lzzZ26/Cortexm0ds/shipinjiaoben/讲解视频脚本.md

# 讲解视频脚本（8 分钟 · 最终版）

> **拆分说明（2026-10-19 更新）**：最终采用"两人各 4 分钟"合成方案。  
> **RTL 部分（0:00–4:00）**：见同目录 **[讲解视频脚本_RTL部分_4分钟.md](讲解视频脚本_RTL部分_4分钟.md)**（已按最新口径重写）。  
> **FPGA 部分（4:00–8:00）**：由另一位同学负责，本文件仅保留总体分镜参考。  
> 本文件其余内容为合并版参考稿，实际录制以 4 分钟 RTL 稿 + FPGA 同学稿件拼接为准。

> **用途**：初赛/决赛"汇报 PPT 及讲解视频"录制。  
> **依据**：赛题要求（PPT≤15 页、视频 mp4、8 分钟）+ 本项目 [README.md](../README.md) 的最终状态。  
> **口径**：FPGA 板级已按 `CORE_TYPE=2`（通用并行核）完成综合与运行；Q18 任意非对称系数在板级与 RTL 三层仿真均闭环。  
> **注意**：全片不得出现学校、队伍、指导老师等识别信息；只讲设计与数据。

---

## 一、录制前置（录前检查）

| 项 | 要求 |
|---|---|
| 视频 | mp4，1920×1080，≤8:00（建议 7:50 收尾），普通话，无背景噪声 |
| PPT | ≤15 页；本脚本按 14 页编排（P1–P14），可合并但不超 15 页 |
| 画面素材 | 架构图、代码片段、仿真图、GTKWave 波形、串口输出、PDS 报告截图 |
| 关键图 | `docs/report/figures/q18_impulse_compare.svg`（Q18 核心证据） |
| 串口素材 | 固件四标记：横幅 / `** ECHO PASS **` / `** DMA PASS **` / `** FIR DONE **` |
| 口径核对 | 吞吐 1.0 sample/cycle；DMA 带宽 14.44 MB/s；系统延迟 3.04 μs；50MHz；APM 82/84（CORE_TYPE=2） |

> 建议语速：约 300 字/分钟。下文每段"讲稿"按该语速配时，可直接照读。

---

## 二、分镜脚本（时间 · PPT · 画面 · 讲稿）

### 0:00–0:30　P1 封面：一句话定位（约 150 字）

**画面**：PPT 封面；右下角小字"RTL 三层验证全绿 · FPGA 板级完成"。

**讲稿**：
> "本作品是'带高阶 FIR 数字滤波器的 SoC 处理器设计'。一句话概括：以 Cortex-M0 为控制核，自研 AXI 多主互连、6 通道 DMA 和**支持任意非对称系数的 81 阶 FIR**，吞吐 1 个样本每拍。RTL 三层验证全绿，FPGA 板级已按通用核综合运行。"

---

### 0:30–1:20　P2 痛点与工程问题（约 250 字）

**画面**：左侧"软件 FIR 太慢"示意图；右侧官方参考工程三处缺口（无多主仲裁、无 DMA、mux/SRAM 并发缺陷）。

**讲稿**：
> "先看问题。边缘设备要同时做系统控制和信号处理。让 CPU 跑 81 阶 FIR，每个样本 82 次乘加，实时性很快见底；纯硬件又难以应对灵活控制。异构 SoC 是标准答案。
>
> 但我们拿到官方参考工程后发现三个工程问题：第一，它只有单主设备，没有多主总线仲裁，源码注释明确写着'没有 DMA 控制器，因此不需要主设备复用器'；第二，没有 DMA，CPU 搬运数据会吃掉大量算力；第三，官方从机复用器和 SRAM 模型在多主并发下有隐藏缺陷——路由会被其他主机的请求刷新，读在途时写会被静默丢弃。这三块，就是我们要补的拼图。"

---

### 1:20–2:10　P3 总体架构（约 250 字）

**画面**：README 架构图（CPU→AHB2AXI→自研仲裁器→自研从机 mux→SRAM/FIR/DMA/APB）。自研模块用蓝色，官方复用用灰色。

**讲稿**：
> "总体架构：Cortex-M0 通过官方 AHB 转 AXI 桥进入 AXI 世界；自研的双主轮询仲裁器把 CPU 和 DMA 两个主设备接到共享总线上；自研的从机复用器按地址选通，把事务分发给 SRAM、FIR、DMA 配置口和官方 APB 子系统。低速外设侧复用官方 AXI 转 APB 桥。
>
> 关键点是：计分模块——仲裁器、从机 mux、地址译码、SRAM 模型、FIR、DMA、ROM——全部自研；官方只读复用指定 CPU 和配套桥。数据流是：SRAM 输入经 DMA 送 FIR，滤波结果再由 DMA 搬回 SRAM，CPU 只负责配系数、下发任务和读结果。"

---

### 2:10–3:10　P4–P5 FIR 三核与 Q18（约 300 字）

**画面**：P4 三核对比表（para 82 乘法器 / sym 41 / serial 1）；P5 Q18 说明：官方答疑原话"支持任意非对称系数"。

**讲稿**：
> "FIR 是本设计的性能核心，也是合规关键。官方答疑明确要求'81 阶可配置系数 FIR，支持任意非对称系数，对称优化只能作为可选分支'。所以我们把**通用全并行核**作为基本架构：82 个独立系数寄存器乘 82 个乘法器，任意非对称系数直接可用，吞吐 1 个样本每拍。
>
> 系数对称时，提供可选的对称优化分支：预加对加 41 个乘法器，资源省一半；通过 CTRL 模式位切换，切换一定伴随全清，不会带脏历史样本。再往下还有单乘法器的串行核，作为资源下限保底。
>
> 一句话：**任意非对称系数是基本盘，对称优化是加分项**。"

---

### 3:10–4:00　P6 定点格式与精度（约 250 字）

**画面**：定点链路图：输入/系数 Q1.15 → 乘积 Q2.30 → 40bit 累加 Q10.30 → 输出 Q1.31；右侧黄金模型流程。

**讲稿**：
> "定点格式全链路统一：输入和系数是 16 位 Q1.15；乘积 Q2.30；82 项累加用 40 位 Q10.30，不会溢出；输出取累加值乘 2 的低 32 位，饱和到 Q1.31。
>
> 这里有两个实现细节：累加器必须声明为有符号，否则 Verilog 会把含乘法的整式按无符号求值；饱和判据必须查满高 10 位，因为 82 项求和可能超过正负 4，只看最高两位会漏判。
>
> 验证口径按官方答疑：**相对均方根误差小于 0.1%**。我们采用更强的逐样本点态上界：每个样本都满足误差不超过参考值的千分之一，数学上蕴含 RMSE 要求。"

---

### 4:00–4:50　P7 DMA：6 通道与链式（约 250 字）

**画面**：DMA 通道框图（读 burst→16 字 FIFO→写 burst）；右侧 7 类用例/6 通道并发/3 段链表示意。

**讲稿**：
> "DMA 有 6 个独立通道，每通道可配源地址、目的地址、传输长度，完成后可发中断。难点在字节精度：源和目的可以任意字节对齐，长度任意，总线又没有字节选通，所以我们用'头尾单拍字节 burst + 中间整字 burst'的三段式搬移，保证零差错。
>
> 链式传输是决赛创新点：每个通道完成后，自动从 NEXT 指针读取下一段描述符继续执行，多段串联不需要 CPU 干预。测试里 3 段链表自动串联、末段中断，全部通过。"

---

### 4:50–5:30　P8 工程难题：BURST 提速死锁（约 200 字）

**画面**：死锁环路示意（ch0 写停等 → 持有授权 → ch1 饿死 → 核无输入/输出 → 循环等待）。

**讲稿**：
> "讲一个真实的工程问题。我们曾把 DMA 的 burst 从单拍提到 8 拍想提速，系统级仿真直接死锁。机制是：输出通道的多拍读追上滤波核产出率，在 DOUT 空时挂起；输入通道的多拍写填满 DIN，而核因为输出满被冻结；停等期间通道一直持有总线授权，另一条通道就饿死了。
>
> 全单拍配置因为'输入受限的锁步节奏'恰好安全。我们把它固化为安全配置，并把根治方向——DMA 双主口——写进了分析文档。"

---

### 5:30–6:20　P9–P10 验证体系与结果（约 250 字）

**画面**：三层验证金字塔；17 个回归目标清单；Q18 冲激对比图（左对称/右非对称）。

**讲稿**：
> "验证按赛题要求分三层。第一层单元/模块：FIR 三个核、DMA、仲裁器、译码、ROM 各有独立 Testbench。第二层集成验证，不含 CPU：VIP 替代 CPU，用真实互连拓扑跑 SRAM 往返、82 系数配置、1024 样本滤波，并且同时验证对称和非对称两轮。第三层系统测试，含 CPU：固件跑 UART 回显、6 通道 DMA 自检、软硬协同滤波，TB 读回 SRAM 逐样本比对黄金模型。
>
> 全量回归 **17 个目标全部通过**，协议检查器零违规。
>
> 右边这张图是 Q18 的直接证据：横轴 82 个抽头。上面是对称系数，冲激响应左右镜像，首尾都是 `0x0004FFF6`；下面是非对称系数，右边首值 `0x16C1D27C`、末值 `0xA633B39A`，左右明显不同。这就是'任意非对称系数'的可视化证明。"

---

### 6:20–7:00　P11–P12 FPGA 验证（约 200 字）

**画面**：PDS 综合报告截图；板卡照片/串口输出；CORE_TYPE=2 配置；50MHz 时序摘要。

**讲稿**：
> "FPGA 侧在 MES50HP 开发板上按 `CORE_TYPE=2` 综合——也就是通用并行核，82 个乘法器支持任意非对称系数。PDS 完成综合、布局布线和 bit 流生成，50MHz 时序收敛；通用核占 82 个 APM，板上乘法器总占用 82/84。
>
> 板上实际运行通过：串口打印横幅、回显通过、DMA 自检通过、FIR 完成。板级时钟采用板载 50MHz 直连，不使用厂商 PLL 或 IP 原语，满足答疑要求。"

---

### 7:00–7:40　P13 同行比较与创新点（约 200 字）

**画面**：对比表：官方参考 vs 本设计（多主仲裁、6 通道 DMA、链式、任意非对称 FIR、并发缺陷修复）。

**讲稿**：
> "和官方参考架构相比，我们补上了多主仲裁和 6 通道 DMA；修复了官方从机 mux 的路由刷新问题和 SRAM 的读写互斥缺陷；FIR 从软件实现变成全硬件、1 样本每拍的加速器，并且把'任意非对称系数'做成默认路径，对称优化作为可选分支。
>
> 创新点集中在三处：一是 Q18 合规的三核架构；二是 DMA 链式传输；三是面向多主并发的仲裁与路由设计。"

---

### 7:40–8:00　P14 成果与应用（约 100 字）

**画面**：应用场景图（传感器滤波/电机控制/音频预处理）；结束页。

**讲稿**：
> "这套设计可以直接用于边缘传感器滤波、电机控制和音频预处理。FIR、DMA 和互连都是参数化的，换工艺、换板卡可以复用。以上是全部汇报，谢谢。"

---

## 三、逐段配时与字数核对

| 时间段 | 页面 | 讲稿字数（约） | 累计 |
|---|---|---:|---:|
| 0:00–0:30 | P1 | 150 | 0:30 |
| 0:30–1:20 | P2 | 250 | 1:20 |
| 1:20–2:10 | P3 | 250 | 2:10 |
| 2:10–3:10 | P4–P5 | 300 | 3:10 |
| 3:10–4:00 | P6 | 250 | 4:00 |
| 4:00–4:50 | P7 | 250 | 4:50 |
| 4:50–5:30 | P8 | 200 | 5:30 |
| 5:30–6:20 | P9–P10 | 250 | 6:20 |
| 6:20–7:00 | P11–P12 | 200 | 7:00 |
| 7:00–7:40 | P13 | 200 | 7:40 |
| 7:40–8:00 | P14 | 100 | 8:00 |

合计约 2400 字，按 300 字/分钟约 8 分钟；建议实际录制控制在 7:40–7:55。

---

## 四、录制素材清单（按出现顺序）

| 序号 | 素材 | 来源/生成命令 |
|---:|---|---|
| 1 | 架构图 | README §2.1；或 `docs/report/技术报告.md` 架构图 |
| 2 | 三核对比表 | README §2.5 |
| 3 | 定点链路图 | 技术报告 §1.2 |
| 4 | Q18 冲激对比图 | `docs/report/figures/q18_impulse_compare.svg` |
| 5 | GTKWave 波形（可选） | `sim_out/q18_impulse.vcd` / `q18_impulse_sym.vcd` |
| 6 | 串口四标记 | `tb_soc` 仿真输出或板上串口截图 |
| 7 | 17 目标回归 | `mingw32-make -f Makefile.fir regression` 输出 |
| 8 | PDS 综合/时序 | 板级 PDS 报告截图（APM 82/84、50MHz 收敛） |
| 9 | 板卡/bit 流 | 板级工程截图 |

> 录屏建议：Q18 对比图用浏览器全屏展示 3–5 秒；回归结果滚动到"全部 PASS"；串口输出停在四标记齐全的一屏。

---

## 五、录制注意事项（避免扣分）

1. **不出现识别信息**：学校、队伍名、指导老师、姓名、单位 logo 一律不出现在画面和口播中。
2. **数字口径一致**：吞吐 1.0 sample/cycle、DMA 带宽 14.44 MB/s、系统延迟 3.04 μs、50MHz；不要临场改数。
3. **Q18 表述准确**：任意非对称系数是默认路径；对称 41 乘加是**可选**分支，不要说成"只能对称"。
4. **FPGA 表述准确**：板级按 `CORE_TYPE=2`（通用并行核）综合；资源口径以 PDS 报告为准（APM 82/84）。
5. **误差口径**：说"相对均方根误差 <0.1%（逐样本 0.0977% 点态上界验证）"，不要只说"误差 0.1%"。
6. **视频长度**：严格 ≤8:00；建议录 7:40–7:55，留剪辑余量。

---

## 附录 A：5 分钟 FPGA 演示视频分镜（决赛可选）

| 时间 | 画面 | 操作/口播 |
|---|---|---|
| 0:00–0:30 | 开发板与上位机 | 上电、串口终端打开；介绍板卡与外设 |
| 0:30–1:00 | 串口横幅 | 复位后打印 `FIR-SoC Demo` |
| 1:00–1:40 | UART 回显 | 发送 64 字符，终端原样回显，出现 `** ECHO PASS **` |
| 1:40–2:40 | DMA 自检 | 6 通道搬运，出现 `** DMA PASS **` |
| 2:40–4:00 | FIR 软硬协同 | CPU 配系数、DMA 搬 1024 样本，出现 `** FIR DONE **` |
| 4:00–4:40 | Q18 演示（若现场可切换） | 说明 CORE_TYPE=2 通用核支持任意非对称系数；展示冲激响应/串口数据 |
| 4:40–5:00 | 收尾 | 板卡运行状态、LED/串口稳定，结束 |

> 演示视频只做"功能正确"展示，不在板上跑长循环误差校验；结果核对由仿真 TB 与离线数据完成（避免 M0 长循环取信异常）。

---

## 附录 B：与 README/PPT 的对应关系

| 本脚本段落 | README 章节 | PPT 页 |
|---|---|---|
| P2 痛点 | §1/§3 | P2 |
| P3 架构 | §2.1–2.4 | P3 |
| P4–P5 三核/Q18 | §2.5、§6 | P4–P5 |
| P6 定点/精度 | §4.4、技术报告 §1.2 | P6 |
| P7 DMA | §2.3、技术报告 §3.3 | P7 |
| P8 死锁 | 技术报告 §3.3 | P8 |
| P9–P10 验证 | §4.1–4.3 | P9–P10 |
| P11–P12 FPGA | §4.5 | P11–P12 |
| P13 比较/创新 | §5 决赛表 | P13 |
| P14 应用 | §10 | P14 |
