lzzZ26/Cortexm0ds/docs/走读笔记-官方参考工程.md

# 走读笔记：官方参考工程（AI初稿，待团队按源码核对）

> **状态**：AI于2026-10-02根据对 `D:\ICT\Cortexm0ds` 源码的阅读起草。
> **使用方式**：团队三人按附录D分工逐条对照源码核实（✅核实无误 / ❌修正并注明），
> 核实完成后删除本提示框，作为技术报告「体系结构设计」章节底稿。
> 来源：本仓库git历史（最新提交 569f446 Revert "版本20260825"，2026-10-01）

## 1. 系统顶层接线（mcu_system/cmsdk_mcu_system/cmsdk_mcu_system.v）

- CPU集成层 `cortexm0integration` 对外是 **AXI-Lite主口**，信号命名：`AW_VALID/AW_READY/AW_SIZE[2:0]/AW_BURST[1:0]/AW_LEN[7:0]/AW_ADDR[31:0]/W_VALID/W_READY/W_LAST/W_DATA[31:0]/B_VALID/B_READY/B_RESP[1:0]/AR_*/R_*`（`cm0_*`前缀）
- 系统共享总线 `sys_*` = 单主直连：源码注释 **"No DMA controller - no need to have master multiplexer"** → 我们补多主仲裁的位置
- 从机风格：**SEL选择线**（`AW_SELx/AR_SELx` 由译码产生，选中才响应）；**W通道不进mux**——`W_VALID/W_DATA/W_LAST`广播给全部从机，从机按自己AW锁存的选中自行消费
- 中断分配：`intisr_cm0[5:0]=apbsubsys_interrupt[5:0]`，`[6]=apb[6]|gpio0_combintr`，`[7]=apb[7]|gpio1_combintr`，`[14:8]=apb[14:8]`，`[15]=apb[15]`，`[31:16]=apb[31:16]|gpio0_intr`，`NMI=watchdog_interrupt`

## 2. CPU集成层端口（core/cortexm0_integration/cortexm0integration.v）

参数：`BKPT/DBG/NUMIRQ(32)/SMUL(0)/SYST(1)/WIC(0)/WICLINES(34)/WPT`。除AXI主口外要点：`FCLK/SCLK/ACLK/DCLK/PORESETn/DBGRESETn/ARESETn/SWCLKTCK/nTRST`、调试（`SWDITMS/TDI/SWDO/SWDOEN/TDO/nTDOEN/DBGRESTART/DBGRESTARTED/EDBGRQ/HALTED`）、`NMI/IRQ[31:0]/TXEV/RXEV/LOCKUP/SYSRESETREQ/IRQLATENCY/ECOREVNUM`、功耗管理（`GATEHCLK/SLEEPING/SLEEPDEEP/WAKEUP/WICSENSE/SLEEPHOLDREQn/SLEEPHOLDACKn/WICENREQ/WICENACK/CDBGPWRUPREQ/CDBGPWRUPACK`）、`SE/RSTBYPASS`。内部实例化 `ahb2axi4_if`（即AHB→AXI4桥，FR-6对应项）。
**核对**：本AI未逐行核对cortexm0integration.v的端口全表，仅从cmsdk_mcu_system.v的实例化反推——**必须对照源码确认**。

## 3. 官方从机复用器（cmsdk_axi_slave_mux.v）

- 10个从机口（PORT0-9），`PORTx_ENABLE`参数开关，`DW=32`
- 主侧信号：`AW_VALID/AW_READY/W_READY/B_VALID/B_RESP/AR_VALID/AR_READY/R_VALID/R_LAST/R_DATA/R_RESP`（**无W通道**，见第1条）
- 从机侧每口：`AW_SELx/AW_READYx/W_READYx/B_VALIDx/B_RESPx/AR_SELx/AR_READYx/R_VALIDx/R_LASTx/R_DATAx/R_RESPx`

## 4. 官方地址映射（cmsdk_axi_addr_decode.v）

| 区域 | 地址 | 说明 |
|---|---|---|
| Flash | 0x0000_0000-0x0000_FFFF | 只读，固件XIP；`filename`参数→$readmemh |
| SRAM | 0x2000_0000-0x2000_FFFF | 64K |
| APB子系统 | 0x4000_0000-0x4000_FFFF | UART0-2/Timer0-1/DualTimer/WDT/测试从机 |
| GPIO0/1 | 0x4001_0000 / 0x4001_1000 | AXI GPIO |
| SYSCTRL | 0x4001_F000 | REMAP等 |
| ROM表 | 0xF000_0000 | |
| 默认从机 | 其余 | DECERR |

## 5. AXI→APB桥（cmsdk_axi_to_apb/axi2apb_axi.v）

FR-6对应项。**核对项**：其对burst/size的处理方式（逐拍转APB？）、PCLKEN分频用法。

## 6. APB子系统（cmsdk_axi2apb_subsystem.v）

**核对项（集成必查）**：`apbsubsys_interrupt`各位中断源——本AI推断 `[0]=UART0 TX、[1]=UART0 RX、[2]=UART1 TX、[3]=UART1 RX、[4]=UART2 TX、[5]=UART2 RX、[6]=TIMER0、[7]=TIMER1、[8:11]=DUALTIMER、[14]=WATCHDOG`，**未经源码确认**。

## 7. 存储模型（cmsdk_axi_flash.v / cmsdk_axi_sram.v）

- Flash：`#(.filename(...), .AW(16), .WS_N/WS_S(来自cmsdk_axi_memory_defs.v的宏))`，只读（写回DECERR），AR侧1拍延迟风格
- SRAM：同样参数化；字节/半字写靠 **AWSIZE+低位地址通道**（CMSDK总线无WSTRB）
- FPGA注意：flash模型是否可综合未确认 → 计划用axi_rom替代（任务15）

## 8. UART（cmsdk_apb_uart.v）

- 波特率分频寄存器（DLL/DLM或等价）、状态位（TXFULL/RXFULL）、TX/RX中断
- 固件驱动用CMSDK_driver（uart_stdout.c）；**核对**：UartStdOutInit默认的UART选择（TB注释为UART2/P1[5]）与波特率（9600）

## 9. 固件框架（software/）

- `retarget.c + uart_stdout.c`：printf→UART stdout；`hello.c`调用`UartStdOutInit()`后printf
- `startup_CMSDK_CM0.s`(GCC版)：向量表；**核对**：IRQ16对应的弱符号名（预期`IRQ16_Handler`）
- `cmsdk_cm0.ld`：FLASH 0x0 64K（rx），RAM 0x20000000 63K（rwx）——注释已为DMA结构预留空间
- 编译流程（hello/makefile）：`arm-none-eabi-gcc -mcpu=cortex-m0 -mthumb ... -T cmsdk_cm0.ld -o x.o` → `objcopy -O verilog x.hex`

## 10. 仿真TB（tb/）

- `tb_cmsdk_mcu`：实例化cmsdk_mcu，`filename="image.hex"`，`cmsdk_clkreset`给时钟复位，`cmsdk_uart_capture`捕获UART输出并在结尾`$stop`
- **坑**：TB无条件`$dumpfile("wave2.vcd")+$dumpvars` → 生成~2.3GB VCD，仿真慢（数分钟）；跑完删
- UART0↔UART1在P1引脚上回环，UART2作stdout

## 11. 复用决策表（AI初稿）

| 官方模块 | 复用方式 | 本项目动作 |
|---|---|---|
| cortexm0integration | 直接实例化（CPU+AHB2AXI4桥） | 无 |
| cmsdk_axi_slave_mux | 直接实例化（PORTx_ENABLE自定，用7个口） | 无 |
| cmsdk_axi_addr_decode | 不实例化 | 新写 ic_axi_addr_decode.v（加FIR/DMA） |
| cmsdk_axi_flash | 仿真用 | FPGA换 axi_rom.v（任务15） |
| cmsdk_axi_sram / cmsdk_axi2apb_subsystem / cmsdk_apb_uart / cmsdk_apb_timer / cmsdk_axi_gpio / cmsdk_axi_default_slave | 直接实例化 | 无 |
| （缺）多主仲裁 | 官方无 | 新写 ic_axi_master_arb.v（任务3） |
| 固件（CMSIS/startup/retarget/链接脚本） | 相对路径引用编译，不拷贝 | 新写 fir_demo 测试程序 |

## 12. 资源预算（任务8 Step 5记录用）

- 对称并行FIR：预加17bit加法器×41 + DSP48×41 + 加法树寄存器约(21+11+6+3+2+1)×40bit
- 串行FIR：1个MAC + 82×16移位寄存器（~1.3K FF）
- 待PDS实际资源报告对比（任务16）
