lzzZ26/Cortexm0ds/验收材料/讲解文档/演示视频分镜.md

# 决赛演示视频分镜（≤5分钟，现场实拍+录屏剪辑）

> 录制自查：时长≤5分钟（mp4）；演示内容与固件/仿真输出一致。
> 上板演示按fpga/pango/README.md板卡到位后拍摄；仿真版演示可先用tb_soc
> 输出录屏替代（口径：验收=仿真正确）。

## 分镜

| 时间 | 画面 | 内容 |
|---|---|---|
| 0:00-0:30 | 板卡全景+串口终端 | 上电，串口（9600-8N1）出现 `FIR-SoC Demo` 横幅（无板卡时：tb_soc录屏+标注） |
| 0:30-1:30 | UART回显演示 | 终端发送任意64字符，逐字原样回显；出现 `** ECHO PASS **` |
| 1:30-2:30 | DMA六通道演示 | 终端打印 `** DMA PASS **`（6通道自检冻结图案零差错）；镜头切TB波形：6通道并发搬运+中断 |
| 2:30-3:30 | FIR滤波演示 | CPU配81系数→DMA搬1024样本→滤波→回收；终端 `** FIR DONE **`；TB黄金比对1024样本<0.1%画面 |
| 3:30-4:00 | 指标展示 | 终端/仿真输出指标：FIR吞吐 核级1.0样本/拍、系统延迟3.04μs、DMA带宽14.44MB/s@50MHz |
| 4:00-5:00 | LED演示+收尾 | GPIO0接LED流水灯/滤波能量等级（固件未加则按README补写）；结尾全景+致谢 |

## 录制清单

- [ ] 串口工具（9600-8N1）就绪
- [ ] 固件四标记依次出现（Demo/ECHO PASS/DMA PASS/FIR DONE）
- [ ] 回显逐字符核对无误
- [ ] 指标数字与docs/指标记录.md一致
- [ ] 视频≤5分钟、声音清晰
- [ ] 素材：tb_soc输出录屏、tb_arb压力录屏、波形截图（死锁对比可选）
