lzzZ26/Cortexm0ds/验收材料/README.md

# 验收材料索引

本目录是提交/答辩用的**整理版材料**，按用途分为四块。原始文件仍保留在仓库对应位置，便于继续修改。

## 讲解文档（`讲解文档/`）

| 文件 | 内容 |
|---|---|
| 项目总览.md | 评委阅读版 README：系统结构、得分点索引、Q18 证据、已知限制 |
| 技术报告.md | 技术报告底稿（架构/详细设计/三层验证/FPGA） |
| 汇报PPT大纲.md | PPT 页级大纲 |
| 讲解视频脚本_RTL部分_4分钟.md | 4 分钟 RTL 讲解逐字稿（前半段） |
| 讲解视频脚本_8分钟合并参考.md | 8 分钟合并版参考稿（两人各 4 分钟） |
| 演示视频分镜.md | 5 分钟 FPGA 演示视频分镜 |
| 指标记录.md | 决赛四项指标与口径 |
| 交付物清单.md | 交付物清单与源码包说明 |

## 仿真（`仿真/`）

| 子目录 | 内容 |
|---|---|
| 波形/ | Q18 冲激响应 VCD（非对称 / 对称），GTKWave 可直接打开 |
| 数据/ | 82 个抽头的输出 CSV（n, y_q31） |
| 图/ | 全部仿真图：三层验证总览、Q18 对称/非对称冲激对比、滤波前后四段波形、幅频响应等 |
| 日志/ | 全量回归（17 目标 PASS）、Q18 波形用例、系统级对称/非对称、集成验证日志 |

关键图：
- `图/verify_three_layers.svg`：三层验证总览（单元 / 集成 / 系统）
- `图/q18_impulse_compare.svg`：Q18 核心证据（对称左右镜像，非对称左右不同）

## 固件（`固件/`）

- `fir_demo.hex`：对称系数演示固件
- `fir_demo_asym.hex`：非对称系数演示固件（`-DFIR_ASYM` 构建）

## 参考资料（`参考资料/`）

- `官方答疑.txt`：赛题官方答疑全文（Q18/Q19/Q5 等口径来源）

## 复现

命令见 `仿真/复现命令.md`。所有仿真均可用仓库根目录的 `Makefile.fir` 重新生成。

> 说明：本目录中的讲解文档是当前版本的副本，仓库中的 `README.md`、`docs/`、`shipinjiaoben/` 仍是可编辑源文件。
