lzzZ26/Cortexm0ds/docs/指标记录.md

# 指标记录（决赛四项 + 资源）

> 口径说明（与技术报告第4/5章一致）：
> - **FIR吞吐量**：核级=**通用全并行核（默认主路径，任意非对称系数）1样本/拍**
>   （tb_fir_core_para断言输出间隔恒1拍）；对称模式（可选优化分支，41乘加）
>   同为1样本/拍（tb_fir_core_sym断言）。系统级=TB监视FIR从机握手（DIN写/DOUT读），
>   含DMA搬运与总线仲裁开销。
> - **DMA带宽**=FIR阶段搬运字节数(4KB进+4KB出=8192B)/耗时（TB按FIR从机握手统计）。
> - **系统总延迟**=首样本DIN写入→首样本DOUT读出（TB监视器直接测量）。
>   计划总览"末拍DIN→首拍DOUT"对流水式FIR不适用（首DOUT远早于末DIN，差值为负）。
> - **CPU主频**：仿真按50MHz记录；FPGA未上板（用户裁定：仿真正确即完成任务），无板级数据。
> - 固件SysTick计时已弃用：官方加密核VAL读回异常（24位计数器不可能出现的差值，
>   实测打印2^32-t1垃圾），指标全部由TB侧测量。

| 指标 | 仿真值(50MHz) | FPGA初版 | FPGA优化版 | 备注 |
|---|---|---|---|---|
| FIR吞吐量 samples/cycle | 核级 **1.0** / 系统级 **0.0363** | — | — | 核级=通用并行核任意系数1样本/拍（tb_fir_core_para）；对称模式（41乘加优化分支）亦为1样本/拍（tb_fir_core_sym）；系统级来自tb_soc指标监视 |
| DMA带宽 MB/s | **14.44**（0.289字节/拍） | — | — | FIR阶段8KB实测；见下方优化方向 |
| CPU主频 MHz | 50 | 50（PDS时序收敛） | — | 仿真时钟（tb_clkreset 20ns周期）；板载50MHz直连（无PLL，答疑#5）；PDS 20ns约束WNS +1.535ns |
| 系统总延迟 us | **3.04** | — | — | 首样本DIN→首样本DOUT（对称核流水~10拍+DMA启动开销） |
| LUT/FF/BRAM/DSP占用 | LUT **25.2%** / FF **10.4%** / DRM **47.8%** / APM **52.4%**（加权约34.9%） | — | — | 板级PDS实测（MES50HP/PGL50H，2022.2-SP6.1，对称FIR构建：LUT 10,772/42,800、FF 6,700/64,200、DRM 64/134、APM 44/84）；通用核82乘法器资源画像见技术报告5.3 |

## 系统级吞吐瓶颈分析（2026-10-04 实证）

- **实测**：系统级FIR吞吐0.0363样本/拍≈27拍/样本，远低于核级的1样本/拍
  （通用并行核与对称核均为1样本/拍）。
- **根因**：T13固件CTRL的BURST字段=0，DMA全程单拍事务（每样本4笔事务×~7拍开销）。
- **尝试提速失败**：把BURST改为7（8拍burst）后系统级仿真**死锁**（实证挂死）。机制：
  1. ch1（DOUT读）8拍FIXED读会追上核产出率→DOUT空→R_VALID停等；
  2. ch0（DIN写）8拍FIXED写会填满DIN（核因DOUT满而冻结）→W_READY停等；
  3. 停等期间通道持有dma_top授权（req=1至事务完成）且总线单事务在途→另一通道饿死→
     核无输入/无输出消费→**循环等待死锁**。T13全单拍因"输入受限锁步"（ch0送样与ch1
     取样节奏锁相）恰好安全，任何一侧多拍burst即破坏锁步。
- **修复方向（留作后续任务）**：DMA双主口——ch0与ch1分占ic_axi_master_arb的两个主口
  （仲裁器本就是双主设计），ch0写停等不再阻塞ch1读排空DOUT，死锁链断裂；
  预期系统级吞吐逼近核极限1样本/拍、带宽数十MB/s。
- **演示输出**：固件不打印cycles（SysTick弃用，见口径说明），串口输出保持
  横幅/ECHO PASS/DMA PASS/FIR DONE四标记，指标由TB打印。
