lzzZ26/Cortexm0ds/验收材料/仿真/复现命令.md

# 仿真复现命令

所有命令在仓库根目录执行。

## 全量回归（17 个目标）

```bash
mingw32-make -f Makefile.fir regression
```

预期：17 个目标全部 PASS，协议检查器零违规。

## Q18 验收波形（非对称 / 对称）

```bash
mingw32-make -f Makefile.fir sim_tb_fir_para_impulse
mingw32-make -f Makefile.fir sim_tb_fir_para_impulse_sym
```

生成：
- `sim_out/q18_impulse.vcd` / `q18_impulse_sym.vcd`（GTKWave）
- `sim_out/q18_impulse.csv` / `q18_impulse_sym.csv`（82 个输出样本）

查看波形：

```bash
gtkwave sim_out/q18_impulse.vcd
gtkwave sim_out/q18_impulse_sym.vcd
```

输出时间：`y[n]` 在 `350 + 20n ns`，n = 0..81。
- 非对称：`y[0] = 0x16C1D27C`，`y[81] = 0xA633B39A`
- 对称：`y[0] = y[81] = 0x0004FFF6`

## 生成图

```bash
python tools/plot_q18_impulse.py    # Q18 对称/非对称/对比图
python tools/plot_verify_layers.py  # 三层验证总览图
python tools/plot_waveforms.py      # 滤波前后四段波形 + 幅频响应 + index.html
```

## 固件重建

```bash
cd sw/firmware/fir_demo
mingw32-make all     # 对称版 fir_demo.hex
mingw32-make asym    # 非对称版 fir_demo_asym.hex
```

## 工具链

- Icarus Verilog 12.0 / vvp
- mingw32-make 4.2.1
- arm-none-eabi-gcc 10.3-2021.10
- Python 3
- GTKWave 3.3.100
