lzzZ26/Cortexm0ds/验收材料/讲解文档/汇报PPT大纲.md

# 汇报PPT大纲（≤15页，内容对应评分要点）

> 评分要点：痛点与工程问题、技术难点与创新点、测试结果与同行比较、成果与应用。
> 数据来源：docs/指标记录.md、docs/report/技术报告.md（保持一致）。

| 页 | 标题 | 内容要点 |
|---|---|---|
| P1 | 封面 | 赛题名称「带高阶FIR数字滤波器的SoC处理器设计」+队名+成员 |
| P2 | 痛点与工程问题 | 边缘计算：CPU做滤波算力不足/通用性差；异构SoC是主流解。工程问题：官方参考工程无多主仲裁（源码注释"No DMA controller..."）；官方mux/SRAM在并发下有隐藏缺陷（多主场景暴露）；DMA与FIR流式协同的死锁边界（BURST提速实测死锁——见P9） |
| P3 | 总体架构 | 一张图：Cortex-M0 → 自研双主仲裁 ← DMA6通道；共享总线 → {ROM/SRAM/FIR/APB}；标注自研模块（仲裁/mux/译码/FIR/DMA/ROM）与官方复用模块 |
| P4 | 技术路线 | 复用+自研清单（复用决策表精简版）；单仓库模式、官方文件只读、Verilog-2001可综合子集 |
| P5 | 多主AXI仲裁设计 | 单事务在途+授权保持到事务完成；读写通道独立授权；无死锁论证；压力TB双主并发零违规、公平性imbalance≤2 |
| P6 | FIR设计：通用全并行核（合规基本盘）+对称41乘加（可选优化分支） | 答疑#18口径：**任意非对称系数是基本盘**——通用核82独立系数×82乘法器+加法树，1样本/拍；系数对称时的可选加速分支=41预加/41乘加（CTRL bit1+CLR切换，模式位在CLR拍锁存）；串行核=资源下限保底；定点Q1.15/Q10.30/Q1.31全链路；饱和判据修正（82项可超±4） |
| P7 | FIR定点与精度 | 黄金模型口径：量化后系数×量化后输入→双精度→量化Q1.31；误差=纯实现误差；**相对均方根误差<0.1%（官方答疑#19口径）——本设计以逐样本0.0977%点态上界验证，数学上强于RMSE要求**；三套系数（对称/非对称随机/大系数饱和）×四段激励 |
| P8 | DMA设计：字节精度+6通道 | 任意对齐/任意长度零差错（头尾单拍字节burst）；FIXED/INCR；6通道并发独立+中断；7类用例TB |
| P9 | DMA链式传输（创新点2）+死锁难题 | 链表自动串联无需CPU干预（决赛加分项）；工程难点：BURST提速实测死锁（多拍FIXED读追平核产出率/多拍FIXED写填满FIFO+授权持有→通道互饿），机制分析+规避+根治方向（DMA双主口） |
| P10 | 验证方法学 | TDD红灯→绿灯循环；协议检查器（4KB/LAST时序/信号稳定性）；VIP；黄金模型；16个回归目标全绿（含非对称专项三层覆盖） |
| P11 | 测试结果 | TB矩阵（16回归目标）；相对均方根误差<0.1%（逐样本点态上界验证）；零差错；指标：核级吞吐1样本/拍、系统延迟3.04μs、DMA带宽14.44MB/s@50MHz仿真 |
| P12 | FPGA工程与验证 | PDS工程/约束/axi_rom（字节流hex装载+窄读通道+门控修正）；ROM路径仿真冒烟通过；上板步骤就绪（README）；口径说明：验收=仿真正确 |
| P13 | 同行比较 | 官方示例架构 vs 本设计：多主仲裁（官方无）、FIR三核（任意非对称系数82乘加1样本/拍为基本盘，对称41乘加为可选分支）、链式DMA、mux/SRAM缺陷修复；指标对比表 |
| P14 | 成果与应用 | 可扩展性（AXI即插即用、DMA参数化通道数、FIR可配置系数）；应用场景：传感器滤波/电机控制/语音预处理 |
| P15 | 致谢/QA | 答疑邮箱/QQ群/社区（Spec第6节）；备份页：死锁波形截图、黄金误差分布 |

**版式要求**：架构图用drawio重画（与报告一致）；每页标注证据文件路径；
P9为答辩重点（难点+创新点=评分项"技术难点与创新点"）。
