lzzZ26/Cortexm0ds/docs/ppt/讲解视频脚本.md

# 讲解视频脚本（8分钟分镜，每段配PPT页与讲稿要点）

> 录制自查：时长≤8分钟（mp4）、穿插演示片段（TB波形录屏+仿真串口输出）、
> 声音清晰无杂音。讲稿要点按自然语速300字/分钟估算，全文约2400字。

## 0:00-0:40 痛点导入（P2）——约200字
"物联网边缘设备要同时做系统控制和信号处理。让CPU去跑81阶FIR滤波，每个样本
82次乘加，算力很快见底；纯硬件又没法应对灵活的控制逻辑。异构SoC——CPU管调度、
硬件加速器管吞吐——是业界的标准答案，也是本赛题的核心。但我们拿到官方参考
工程后发现：它连多主设备的总线仲裁都没有，注释里写着'No DMA controller -
no need to have master multiplexer'。这就是我们要补的第一块拼图。"

## 0:40-1:30 总体架构（P3/P4）——约250字
"我们的方案：Cortex-M0负责系统控制，通过自研的双主AXI轮询仲裁器与6通道DMA
共享总线；总线上挂ROM、SRAM、官方APB外设，以及两块自研加速器——FIR滤波器和
DMA配置口。蓝色是我们自研的模块，灰色是官方复用模块。全部新代码用Verilog-2001
可综合子集，官方文件只读不改，靠实例化复用。"

## 1:30-2:30 仲裁器+FIR三核（P5-P7）——约300字
"仲裁器设计抓住一点：单事务在途、授权保持到事务完成——从协议层面杜绝死锁，
读写通道独立授权互不阻塞。压力测试里两个主设备并发互打32笔写32笔读，协议
检查器零违规，轮询公平性偏差不超过2。
FIR是本设计的性能核心，也是合规关键。官方答疑明确要求'支持任意非对称系数'，
所以基本架构是**通用全并行核**：82个独立系数乘82个乘法器，任意系数都能跑，
吞吐1个样本每拍；系数对称时再提供**可选优化分支**——41预加+41乘法，通过CTRL
模式位切换，切换必然伴随全清，不会带脏历史样本；另有单乘法器串行核作为资源
下限保底。定点格式全链路统一：输入系数Q1.15、累加器Q10.30、输出Q1.31，饱和
判据经过修正——82项求和可以超过±4，只看高两位会漏判。误差验证用黄金模型：
三套系数（对称/非对称/大系数）各1024样本、四段激励，逐样本相对误差都低于
0.0977%，比要求的0.1%还严。"

## 2:30-3:30 DMA与链式（P8/P9）——约300字
"DMA的难点在字节精度：源和目的地址任意对齐、长度任意字节，总线没有字节选通，
靠的是头尾单拍字节burst加中间整字burst三段式搬移。六通道并发独立工作、数据
零差错，七类用例全部通过。链式传输是决赛加分项：每个通道完成一段后自动从
链表读下一段描述符继续跑，三段串联全程不需要CPU干预。
这里有个值得讲的工程问题：我们把固件的BURST从单拍提到8拍想提速，系统级仿真
直接死锁。深挖下去是两个机制叠加——输出通道的多拍读会追上滤波核的产出率，
在FIFO空的时候挂起；输入通道的多拍写会把FIFO写满，而核因为输出满在冻结；
挂起期间通道死握着总线授权，另一条通道就饿死了。全单拍配置因为输入受限的
锁步节奏恰好安全。我们规避了死锁，并把根治方向——DMA双主口——写进了文档。"

## 3:30-4:30 验证方法学（P10/P11）——约300字
"验证是我们的地基。每个模块先写自检测试平台，红灯——模块不存在，实现，绿灯
——断言全过，才提交。协议检查器挂在主口上盯4KB边界、LAST时序、信号稳定性。
十三个测试平台全绿：仲裁压力、地址译码全覆盖、FIR黄金回归、DMA七类用例、
六通道并发、链式、SoC冒烟、系统级软硬协同——回显64字符、DMA自检、FIR滤波
黄金比对全部通过。系统级实测：核级吞吐1样本每拍，系统延迟3.04微秒。"

## 4:30-5:30 FPGA结果与指标（P12）——约250字
"FPGA侧工程文件全部就绪：板级顶层、约束、以及替代仿真flash的axi_rom。axi_rom
有三个实现细节值得一提：固件hex是字节流格式，按字节数组装载才对；窄读要把
数据摆到地址对应的字节通道；地址握手要按选通信号门控。ROM路径的冒烟仿真
已经通过——CPU直接从ROM启动输出Hello world。板卡到位后按README建工程综合
烧录即可。"

## 5:30-6:30 同行比较（P13）——约250字
"和官方参考架构对比：官方没有多主仲裁，我们补齐了；官方从机复用器的响应
路由按电平锁存，多主并发下会串台，我们用事务队列重构了它；官方SRAM模型
在读在途时静默丢写，我们替换了它——这几个缺陷都是多主场景才暴露的，单主
系统永远测不出来。FIR从串行核到对称41乘加是性能上的跨越，DMA链式传输是
官方示例里的加分项，我们也实现了。"

## 6:30-7:30 成果应用与总结（P14）——约250字
"这套SoC是参数化、可扩展的：FIR系数可配置，DMA六通道即插即用，AXI总线上
可以继续挂新的加速器。应用场景：工业传感器的实时滤波、电机控制的信号调理、
语音信号预处理。总结：一个跑通的异构SoC、两块加速器、一条经得起压力测试的
总线、一套有据可依的验证方法——这就是我们的作品。"

## 7:30-8:00 结束语（P15）——约100字
"感谢观看，欢迎提问。"（+QA备用页提示）

## 演示片段插入点
- 1:30段：插入 tb_arb 压力测试录屏（PASS行+violation=0）
- 2:30段：插入 tb_fir_core_sym 黄金回归录屏
- 3:30段：插入 tb_dma_chain 链式录屏 + 死锁波形截图（8拍BURST挂死vs单拍通过）
- 4:30段：插入 tb_soc 完整输出录屏（四标记+指标段）
