lzzZ26/Cortexm0ds/(commit log)

2025-10-24 版本20251024
2025-11-28 版本20251128
2026-06-09 版本20260609
2026-08-25 版本20260825
2026-10-01 Revert "版本20260825"
    This reverts commit 3bbefc4fac7b4854f771cf7fc0189c1aa5efd9cc.
2026-10-02 chore: 单仓库模式——项目文档入库、仿真入口Makefile.fir、忽略规则整理
    - 官方代码保持只读；新增 docs/(Spec+计划+走读笔记)、yaoqiu/ 入库共享
    - Makefile.fir：本项目仿真入口（官方makefile不动，同名冲突规避）
    - run.out 移出索引（编译产物），追加 *.vvp/*.fst/.vs//sim_out/ 忽略规则
2026-10-03 feat: 仿真基础设施（AXI VIP/协议检查器/存储从机/UART BFM）自测通过
2026-10-03 feat: 双主AXI轮询仲裁器（压力测试+协议零违规）
2026-10-03 feat: 本项目AXI地址译码（新增FIR/DMA区域）
2026-10-03 feat: FIR黄金模型生成器（量化口径）
2026-10-03 feat: 串行FIR核（黄金对比误差<0.1%）
2026-10-03 feat: FIR AXI从机封装（系数配置+FIFO数据口）
2026-10-03 feat: 对称并行FIR核（41乘加，1样本/拍）
2026-10-03 feat: 单通道DMA引擎（读burst+FIFO+写burst，7类用例零差错+协议零违规）
    - dma_channel：源/目的对齐自适配（字节/半字/字），16字FIFO读写交替，
    4KB边界拆分，FIXED_SRC/FIXED_DST，链式描述符续传（CHAIN）
    - 修正计划代码缺陷：状态寄存器3位回绕、bready在数据阶段提前置位、
    wdata握手沿预取（避免滞后一拍）、读写切换握手（fc==16/0）、
    源首字偏移字节拍、wlast组合输出（NBA版末拍晚一拍，协议检查器报缺失）
    - TB拓扑：VIP与DMA经ic_axi_master_arb汇入同一slave_mem（双主不能直连）
    - axi_slave_mem：字索引修正[AW+1:2]（12位），此前0x1000以上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
    [axi_slave_mem.v, dma_channel.v, tb_dma_channel.v]
2026-10-03 feat: 6通道DMA控制器（并发独立零差错+中断）
    - dma_top：6×dma_channel + burst粒度轮询仲裁 + CMSDK从机配置口 + 中断聚合
    - 通道仲裁：req在读写切换点下拉即释放授权，组合扫描从上一授权通道+1起
    轮询（计划原文gnt<=gnt+1且释放清零会饿死0号通道）
    - 配置口寄存器译码修正：通道号=addr[8:5]、寄存器号=addr[4:0]
    （计划原文[11:8]/[6:0]除通道0外全部失效）
    - bready/rready取被授权通道信号（计划原文把1'b1硬接输出口多驱动冲突）
    - 读状态机单拍R_LAST=1（AXI要求）；R_RESP仅时序块驱动避免双驱动
    - TB拓扑与soc_top一致：VIP与DMA主口经ic_axi_mast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
    [dma_top.v, tb_dma_top.v]
2026-10-03 feat: DMA链式传输（链表自动串联，无需CPU干预）
    - dma_channel：新增chain_cont内部续传标志——S_CH_D收齐5字描述符后置位，
    S_IDLE按chain_cont从shadow装载下一段（cfg_load是dma_top的一次性装载
    脉冲不会二次出现，原实现链式续传死等）
    - dma_channel：新增irq_o输出（完成&&本段IRQ_EN脉冲）——链式末段由描述符
    IRQ_EN驱动中断，非链式由寄存器IRQ_EN驱动，统一为通道内done&&irq_en
    - dma_top：中断聚合改采通道irq_o（原实现只看寄存器IRQ_EN位，链式启动
    寄存器IRQ_EN=0时末段中断永不触发）
    - TB：3段链表（0x000→0x300、0x040→0x340、0x080→0x380）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
2026-10-03 feat: SoC顶层集成（CPU+仲裁+官方子系统+FIR+DMA），冒烟通过
    修复两个集成根因：
    1. 官方cmsdk_axi_ram_beh写锁存带读写互斥，仲裁器1拍授权延迟使
    CPU桥的"读在途+写AW重叠"命中互斥窗口，写静默丢失（B仍OKAY）
    → 新写rtl/soc/axi_sram_sim.v替代（无互斥，官方文件不动）
    2. GPIO1区域译码后悬空无从机响应，写ALTFUNCSET时AW_READY恒0死锁
    → 实例化官方cmsdk_axi_gpio为GPIO1，接mux port7
    另修正：IRQ位序按官方源码（[15]=DMA槽位）、PCLKEN=1、
    冒烟TB改HSTM拍采样UART捕获（hello固件位宽=1拍，波特采样收不到）
    [axi_sram_sim.v, soc_top.v, tb_soc_smoke.v]
2026-10-04 feat: T13固件与系统级联调全绿（自研mux队列/FIR反压/黄金比对TB）
    - ic_axi_slave_mux：事务队列路由（官方mux VALID电平锁存，多主并发下
    路由被其它主机请求刷新，DMA收到错误从机的R/R_LAST致传输夭折）
    - fir_top：DOUT空读停等（不再返回陈旧值）、AR/AW按SEL门控（幻影事务）、
    DIN满反压、FIFO推弹计数统一互斥更新（消除跳拍）
    - fir_core_sym：输出侧反压（FIFO满冻结流水，不再丢输出）
    - fir_demo固件：UART0回显+6通道DMA自检（冻结图案）+FIR软硬协同+中断
    演示；误差校验在TB侧与golden_q31.hex比对（1024样本<0.1%）
    - tb_soc系统级验证；soc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
2026-10-04 feat: 决赛四项指标测量（TB监视器+固件SysTick弃用+指标记录）
    - tb_soc.v: 指标监视块（FIR从机din_push/dout_pop握手统计）+最终判定块打印
    吞吐/延迟/带宽并断言合理范围；实测 核级1.0/系统级0.0363样本每拍、
    系统延迟3.04us、DMA带宽14.44MB/s@50MHz
    - fir_demo.c: 弃用SysTick计时（官方加密核VAL读回异常，实测打印2^32-t1垃圾），
    指标改由TB侧测量；曾尝试BURST=7提速，引发系统级死锁（多拍FIXED读写
    停等持有DMA授权致通道互饿，机制分析见docs/指标记录.md），回退单拍
    - docs/指标记录.md: 决赛四项指标表+瓶颈分析与修复方向（DMA双主口）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
    [fir_demo.c, tb_soc.v]
2026-10-04 feat: FPGA工程文件（axi_rom+自检TB+约束+板级顶层模板），ROM路径冒烟通过
    - rtl/fpga/axi_rom.v: FPGA用只读ROM。与计划原文三处修正（均经TB实证）：
    ①内存改字节数组+字节流hex装载（objcopy -O verilog是字节流格式，
    按32位字数组装载字节序全错——实测hello.hex的rom[0]读回0x00000000
    而SP应为0x2000FC00，冒烟超时）；②窄读按官方ram_beh语义摆通道
    （数据在地址对应字节通道、未选通道=0，AHB2AXI桥不搬通道）；
    ③AR_READY按AR_SEL门控（共享总线幻影事务，fir_top同病）。
    另R_LAST改组合逻辑（寄存版滞后一拍，末拍呈现0被检查器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
    [axi_rom.v, soc_top.v, tb_axi_rom.v, tb_soc_smoke.v, top_pgl.v]
2026-10-04 docs: 技术报告底稿（五大部分+复用决策表+指标数据+死锁分析）+计划状态回写
    - docs/report/技术报告.md：按计划大纲五大部分（工作原理/体系结构/详细设计/
    验证与分析/FPGA），模块名/寄存器地址/指标数字与源码和仿真输出一致
    （grep抽查通过）；第5章口径按用户裁定调整为'工程准备+ROM路径仿真验证'
    - 复用决策表按代码现状（官方mux/SRAM已被自研版替代，附根因）
    - 计划文档回写T14/T15/T16执行状态与裁定摘要（保持计划=真相）
    - DOC/PDF导出（WPS）与架构图drawio重画留团队执行
2026-10-04 docs: 汇报PPT大纲（15页版式）+讲解视频脚本（8分钟分镜）
    PPT大纲覆盖评分五点（痛点/难点创新/测试结果/同行比较/成果应用），
    P9以DMA死锁难题作为答辩重点；视频脚本按8分钟分镜配讲稿要点与
    演示片段插入点。录制与自查由团队执行（时长≤8min、mp4）。
2026-10-04 feat: 代码规范统一（时钟复位命名）+源码包+演示视频分镜（T19）
    - 命名统一：fir_core/fir_core_sym/dma_channel的clk/rstn与ic_axi_master_arb的
    aclk/aresetn统一为ACLK/ARESETn（CMSDK风格，与其余模块一致），
    实例连接同步更新——代码规范性10分要求命名一致
    - tools/package_src.sh：源码包打包脚本（剔除官方文件/编译产物，
    官方工程下载指引随包）
    - deliverables/：源代码包.zip（107KB）+交付物清单与状态README
    - docs/ppt/演示视频分镜.md：决赛演示视频分镜（≤5分钟+录制清单）
2026-10-04 chore: Makefile.fir增加all默认目标（系统级仿真）与regression全量回归目标
    纯make（GNU Make 4.2.1）已验证可用：make -f Makefile.fir sim_tb_axi_rom PASS。
2026-10-04 feat: FIR滤波前后信号波形图（SVG零依赖生成器）+报告引用
    用户提问澄清：赛题'输入波形→滤波后波形'在仿真中真实发生（1024样本
    数值比对验证），本提交补上信号波形可视化——6张SVG矢量图：
    冲激响应/通带正弦/阻带衰减/噪声平滑/系数对称/幅度频率响应，
    由tools/plot_waveforms.py纯标准库生成（无需matplotlib），
    index.html浏览器双击可看，技术报告4.5节引用。
2026-10-04 feat: 集成验证TB（无CPU核）——赛题三层级验证第二层补全
    tb_integ.v：VIP替代CPU，互连拓扑与soc_top一致（仲裁器+从机复用器+
    地址译码+SRAM+FIR对称核+DMA+默认从机），验证链：SRAM往返16拍INCR→
    82系数配置→1024样本入SRAM→DMA搬运（单拍，T14死锁裁定）→轮询DONE→
    读回黄金比对1024样本<0.1%+协议零违规。一次通过@658us。
    技术报告4.1按赛题要求显式映射三个层级验证，4.3补tb_integ行，
    regression目标更新为14个TB。
2026-10-18 docs: 合规修复计划（任意非对称系数FIR+口径修正，依据官方答疑Excel）
2026-10-18 docs: 合规修复计划细化——设计决策回写（CLR语义/模式锁存/对称核LUT实现/双套非对称黄金）
2026-10-18 fix: 修复T19重命名过度波及——tb_fir_core/tb_fir_core_sym的tb_clkreset实例化连接恢复.clk/.rstn（模块端口未随重命名改，elaboration报port not found，回归红灯）
2026-10-18 feat: 通用全并行FIR核（82乘加，任意系数1样本/拍，非对称黄金回归）——用例A-D全绿（对称+非对称+大系数饱和+吞吐）；用例E中途CLR待修（clr未清移位寄存器，疑delta竞争，台账记录）
    WIP: sim_tb_fir_core_para 用例E红灯
2026-10-18 fix: 修复T19重命名残留——tb_dma_channel的dma_channel实例化连接.clk/.rstn改.ACLK/.ARESETn（模块端口已重命名，elaboration报port not found）
2026-10-18 fix: 并行FIR核TB用例E——clr脉冲改NBA驱动，消除与核always块的delta竞争（阻塞赋值下核可能整拍采样不到clr=1，中途CLR稳定失败）
    sim_tb_fir_core_para全用例绿（A对称/B非对称/C大系数饱和/D吞吐/E CLR/F cfg），全量回归15TB全绿
2026-10-18 feat: FIR从机双核模式（通用并行核默认+对称核可选优化分支，CLR语义扩展）
    - CORE_TYPE扩展：0串行/1对称/2通用并行/3双核（para默认+sym运行时可选）
    - 模式位CTRL bit1在CLR写拍锁存（切换必然全清）；cfg广播双核；dout按模式mux
    - fir_core/fir_core_sym新增clr端口（设计决策1）；对称核加use_dsp=no属性（PGL50H资源约束）
    - tb_fir_top参数化CORE_TYPE并新增双模用例（非对称/切sym/切回/饱和）；Makefile加sim_tb_fir_top_dual
    - 全量回归16目标全绿
2026-10-18 feat: 系统集成通用并行FIR核（非对称系数系统级黄金回归）
    - soc_top/tb_integ FIR实例切换CORE_TYPE(3)双核（para默认，任意非对称系数合规主路径）
    - tb_integ增补非对称系统级用例：CLR→配coeff_asym→ch2/ch3 DMA搬运1024样本→
    读回与golden_asym比对<0.1%（ch0/ch1的DONE锁存不可清，复用ch2/ch3判新完成）
    - fpga/pango/README增加CORE_TYPE决策矩阵（PGL50H/PG2L100H/A7-35T）
    - 全量回归16目标全绿（含tb_soc固件路径与tb_integ双模）
2026-10-18 docs: 合规口径修正（相对均方根误差/非对称架构/无厂商IP流程）
    - 技术报告：误差口径改相对均方根误差<0.1%（答疑#19，逐样本0.0977%点态上界更强）；
    FIR章节重写为三核架构（通用并行核=任意非对称系数合规基本盘，对称核=可选分支，串行核=保底）；
    新增非对称验证专项（核级/从机级/系统级三层）；4.3测试矩阵补tb_fir_core_para/tb_fir_top_dual
    - PPT大纲P6/P7同步改写（非对称=基本盘，对称=创新分支）；TB计数/P11/P13同步
    - top_pgl.v删PLL改板载50MHz直连（答疑#5计分项不用厂商IP/原语）；constraints.fdc同步
    - README：删PLL步骤；ROM备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
2026-10-18 test: 评审修复——补para/sym随机输出反压与双模模式判别（变异测试证明有效）
    - tb_fir_core_para用例G：随机dout_ready（3/4接受），接受拍记分板，1024/1024全对，
    stall 369拍；变异stall=1'b0→超时红灯
    - tb_fir_core_sym相位2：随机反压+AXI式推流驱动（原驱动忽略din_ready，反压会丢样本），
    stall 366拍；变异stall=1'b0→错点+超时红灯
    - tb_fir_top双模⑤模式判别：仅c[0]=0x4000+冲激，para y[81]=0 / sym y[81]=0x3FFF8000；
    变异mode_reg<=1'b0→⑤b失败
    - 全量回归16目标/17 PASS exit0
2026-10-18 feat: 非对称演示固件（Q18板级移交）
    - gen_fir_golden.py：fir_golden.h新增fir_coeff_asym数组（原数据文件逐字节不变）
    - fir_demo.c：-DFIR_ASYM选择非对称系数表，FIR流程与对称版完全一致；打印** FIR ASYM MODE **
    - makefile：新增asym目标，产出fir_demo_asym.hex/.bin/.lst（out_buf地址与对称版一致0x20000468）
    - tb_soc参数化（FIRMWARE/GOLDEN_FILE/OUT_IDX）；tb_soc_asym固化asym固件+golden_asym
    - Makefile.fir新增sim_tb_soc_asym并纳入回归
    - 收口计划2026-10-19-fpga-q18-handover.md：RTL变更清单/板级步骤/冲激响应期望值/风险回退
    - 验证：对称PASS + 非对称PASS（1024样本<0.1%）；全量回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
2026-10-19 feat: Q18验收波形——非对称系数冲激响应TB+VCD+SVG图
    - tb_fir_para_impulse：82非对称系数+冲激，前82输出与golden_asym逐位相等（自检PASS）
    - 生成 sim_out/q18_impulse.vcd（GTKWave可看）与 q18_impulse.csv
    - tools/plot_q18_impulse.py：读仿真CSV+系数生成 q18_impulse_asym.svg（零依赖）
    - 图中 y[0]=+0.1778 / y[81]=-0.7015，左右明显不对称即Q18证据
2026-10-19 feat: 对称/非对称冲激响应双套仿真波形+对比图
    - tb_fir_para_impulse参数化（系数/黄金/VCD/CSV/TAG）；新增tb_fir_para_impulse_sym包装
    - Makefile加sim_tb_fir_para_impulse_sym目标
    - 绘图脚本自动量程，生成sym/asym/compare三张SVG
    - 实测：sym y[0]=y[81]=0x0004FFF6（镜像）；asym y[0]=0x16C1D27C/y[81]=0xA633B39A（明显不同）
    - VCD：sim_out/q18_impulse.vcd（asym）、q18_impulse_sym.vcd（sym）
2026-10-19 fix: 冲激波形从冲激前开始dump——避免配置段(3.3us)与字符串参数淹没波形
    旧VCD从0时刻录且dump了文件名参数，GTKWave里前3.3us全是0/x；
    改为CLR后、冲激前启动dump，单scope只含关键信号，波形即82点冲激响应。
2026-10-19 fix: VCD改用干净probe scope（仅clk/din/dout/valid/clr）
    $dumpvars(1,TB)会把字符串参数(COEFF_FILE等)导成208位变量，
    GTKWave对$var parameter显示xxxx，误以为整条波形无效。
    新增q18_wave_probe只含9个关键信号。
2026-10-19 fix: 波形从时间0开始且压缩前导段（复位2us→100ns，系数直接初始化）
    - tb_clkreset加RESET_CYCLES参数（默认100，其他TB行为不变）；波形TB用5周期
    - 波形TB绕过82项配置段（直接初始化核内系数；cfg接口功能由tb_fir_core_para用例F覆盖）
    - 新VCD：#0~2.39us，240个clk跳变、83个dout值，Zoom-Fit即可看全
2026-10-19 docs: 评阅版收尾报告README（系统结构/仿真图目录/得分点索引/Q18证据/已知限制）
    - 新增根README.md：评委3分钟导航、架构图、模块清单、地址映射、三层验证、
    初赛/决赛得分点对照表（每项到代码/证据位置）、Q18专项、复现指南、如实限制
    - 自检同步：讲解视频脚本FIR段改为三核口径（非对称=基本盘，对称为可选分支）；
    deliverables/README更新为17回归目标+asym固件/波形命令
    - 基线：全量回归17目标全PASS exit0
2026-10-19 docs: FPGA板级验证完成——更新README/报告/指标（PDS实测资源与时序）
    - 初赛FPGA综合验证20分项：✅完成（PDS 2022.2-SP6.1，bit流生成，50MHz时序收敛）
    - 资源实测：LUT 10772/42800(25.2%)、FF 6700/64200(10.4%)、DRM 64/134(47.8%)、
    APM 44/84(52.4%)，赛题权重加权约34.9%
    - 时序：Setup(Slow) WNS +1.535ns、Hold +0.037ns、Setup(Fast) +6.943ns
    - 新增README §4.5板级验证结果；同步技术报告5.3/5.4与指标记录
    - 口径说明：板级构建为对称分支(41乘法器)；Q18通用核由RTL三层仿真闭环，
    板上演示非对称可按CORE_TYPE=2重综合
2026-10-19 docs: 板级口径修正为CORE_TYPE=2（通用并行核）
    - 板级按CORE_TYPE=2综合运行（82乘法器，任意非对称系数直接可用），Q18板级闭环
    - README §4.5/§1/§5/§8/§10同步；技术报告5.3/5.4与指标记录同步
    - 资源口径：CORE_TYPE=2 通用核 APM 82/84；LUT/FF/DRM 以板级报告为准；
    本机保留的PDS实测（APM 44/84等）标注为对称分支参考构建
    - 待补：CORE_TYPE=2 PDS报告的LUT/FF/DRM与WNS精确数值
2026-10-19 docs: 8分钟讲解视频脚本（按赛题要求+README最终口径）
    - 14页PPT分镜：痛点/架构/FIR三核与Q18/定点精度/DMA与链式/死锁难题/
    三层验证/FPGA CORE_TYPE=2/同行比较/应用
    - 逐字讲稿约2400字（8分钟@300字/分钟）+ 配时表 + 素材清单 + 录制注意事项
    - 附录：5分钟FPGA演示视频分镜；不出现任何识别信息
2026-10-19 docs: 4分钟RTL讲解视频脚本（两人各4分钟合成方案）
    - 新增讲解视频脚本_RTL部分_4分钟.md：项目背景/主要工作与设计方案/RTL测试结果与分析
    - 约1160字，3:50-3:55实录，结尾交接FPGA部分
    - 8分钟总稿标注拆分说明：RTL部分以4分钟稿为准，FPGA由另一位同学负责
    - 含配时表/素材清单/录制注意事项/拼接约定
2026-10-19 docs: RTL讲解稿改为连续口播稿（去掉分点/表格）
2026-10-19 docs: RTL讲解稿项目背景改为赛题官方背景（异构SoC/边缘计算/硬件加速必然性）
2026-10-19 docs: 措辞修正——官方参考工程为基础框架，赛题要求补齐缺失部分
    - 讲解稿背景段：不再说官方工程'有问题'，改为'单主基础框架，需在其上补齐
    多主仲裁/DMA/FIR；面向多主并发增强基础mux/SRAM'
    - 分析段同步；README模块说明与多主互连条目同步
2026-10-19 docs: RTL讲解稿聚焦代码架构/创新点/仿真结果，移除官方工程相关表述
2026-10-19 docs: humanizer-zh润色RTL讲解稿（去模板化表达，保留全部事实与数字）
2026-10-19 chore: 整理验收材料与仿真输出（讲解文档/仿真/固件）
    - 新增验收材料/：讲解文档、仿真（波形/数据/图/日志）、固件、官方答疑
    - 新增三层验证总览图 verify_three_layers.svg 与生成脚本 plot_verify_layers.py
    - README更新验收材料路径，并修正图目录/复现指南的章节锚点
    - 4分钟RTL讲解稿按项目实际校正并润色
    - 清理构建产物（sim_out、wave2.vcd、run.out、固件.o/.lst/.bin）；重新打包源代码包
2026-10-19 chore: 文档去重——讲解文档只保留验收材料一份
    - 删除已归档的原始文档：技术报告、汇报PPT大纲、演示视频分镜、指标记录、
    deliverables/README、FPGA工程说明、FPGA收口计划、shipinjiaoben 两份讲解稿、
    旧版 docs/ppt/讲解视频脚本
    - 根README改为指向验收材料的短索引，避免重复内容
    - 交付物清单更新为新位置；打包脚本改为从验收材料/讲解文档取README与讲解文档
    - 重新打包源代码包（含讲解文档目录）
2026-10-19 chore: 删除deliverables源码包（由团队自行打包，清单改为参考结构）
